littlefishsolutions/Arduino-HRV/Photos - Arduino Installation/SSR Relay board.jpg

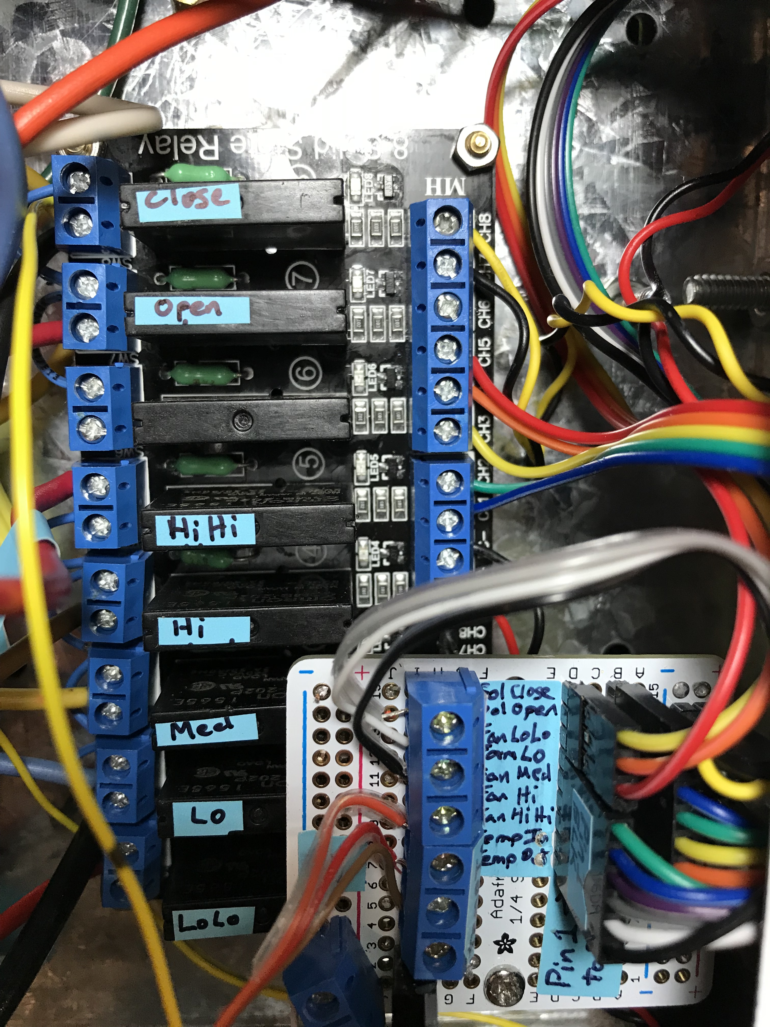
Photos - Arduino Installation/SSR Relay board.jpg
