littlefishsolutions/Arduino-HRV/Photos - Arduino Installation/Remote OLED display enclosure.jpg

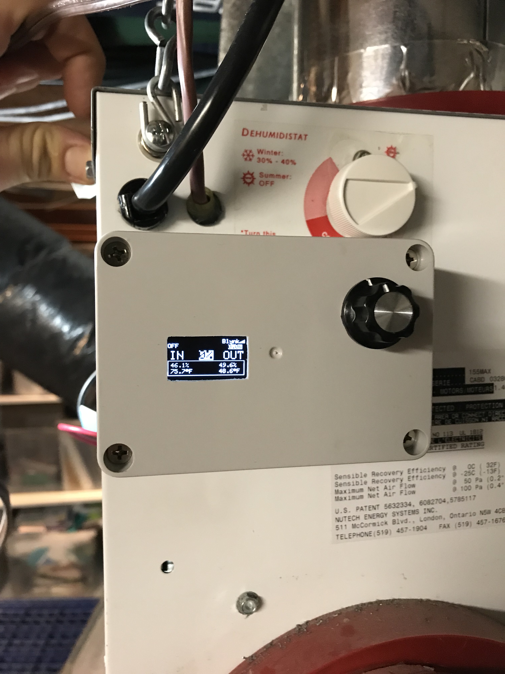
Photos - Arduino Installation/Remote OLED display enclosure.jpg
