littlefishsolutions/Arduino-HRV/README.md

# Arduino-HRV
<h3>HRV Arduino Controller with Air Economizer</H3>

So my history with this project is I live in Minnesota and my HRV PCB board fried.  I always wanted something with an air economizer since our springs and falls are perfect times to take in cool outside air and condition the house rather than turning on the air conditioner or opening windows.  This is where this project fits in.  

I wrote up a detailed description of operation.  Refer to HRV Control Narrative.docx in the source code.  The wiring diagram is also attached in the library.

<H2>HARDWARE:</H2></BR>

(1) [Arduino ESP32](https://www.aliexpress.com/item/Official-DOIT-ESP32-Development-Board-WiFi-Bluetooth-Ultra-Low-Power-Consumption-Dual-Core-ESP-32-ESP/32819024360.html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) - Used due to the amount of GPIO required for this project.  ESP8266 just wasn't enough GPIO.

(1) [120V to 5V step down power supply](https://www.aliexpress.com/item/1x-HLK-PM01-AC-DC-220V-To-5V-Step-Down-Power-Supply-Module-Household-Switch-P0/32795822005.html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) - Don't use the cheap power supply PCB's.  I went through two other types before I found out that this was the most stable.

(2) DHT 22 temperature sensors - [Inside sensor](https://www.aliexpress.com/item/1pcs-Free-Shipping-DHT22-AM2302-Digital-Temperature-and-Humidity-Sensor/1041496689.html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) & [Outside Remote Sensor](https://www.aliexpress.com/item/1PCSX-DHT22-AM2302-Digital-Temperature-and-Humidity-Sensor-AM2302-with-wire/32767774502.html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). Measure inside and outside temperature and humidity.

(1) [0.96" OLED display](https://www.aliexpress.com/item/free-shipping-0-96-inch-OLED-display-module-128X64-OLED-For-arduino-I2C-IIC-SPI-7p/32595065663.html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) for local indication of the mode it is operating and for temp/humidity indication.  Be sure you desolder and solder pins so that board is configured for I2C communication. Instructions for SPI and I2C can be found [here](https://forum.arduino.cc/index.php?topic=472436.0).

(1) [8-Channel SSR 5 Volt High Level trigger relay board](https://www.aliexpress.com/item/Free-Shipping-5V-8-Way-High-Level-Trigger-Solid-State-Relay-Module-with-Fuse-Arduin-250V2A/32572982881.html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)

(1) [LM1117 Linear Voltage regulator](https://www.aliexpress.com/item/10PCS-LM1117T-3-3-TO220-LM1117-3-3-LM1117T-3-3V-LM1117-TO-220-free-shipping/32714386720.html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) to power ESP32 at 3.3V

(1) [Rotary Encoder KY-040](https://www.aliexpress.com/item/The-32TA1600-logic-board-320WA01C-BF-C67271-In-stock-Best-price-and-good-service/599712551.html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) & [Knob](https://www.aliexpress.com/item/5pcs-A01-Bakelite-Knob-20MMxH11-5MM-Mounting-Hole-6MM-For-Rotary-potentiometer-Encoder-Rotary-Switch/32802763478.html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) used as a push button.  Future functionality to include a menu and be able to select modes of operation and control setpoints.

(1) [Enclosure](https://www.aliexpress.com/item/1Pcs-DIY-2-Size-Plastic-Waterproof-Housing-Enclosure-Box-Electronic-Project-Instrument-Case-Outdoor-Junction-Box/32839180611.html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) to house the OLED display and encloder.  Get the large one.  Dimensions are 100mmx68mmx50mm.

<H2>SOFTWARE:</H2></BR>
Blynk App for iOS to control and monitor the status of the controller.  Refer to the Blynk Project Link in the source code.  It is a QR code that you need to scan to clone the configuration to make it yours.

<H2>ARDUINO LIBRARIES USED:</H2></BR>
WiFi.h, WiFiClient.h, BlynkSimpleEsp32.h, ArduinoOTA.h, mDNS.h, WiFiUdp.h, SPI.h, Wire.h, Adafruit_SSD1306.h
