littlefishsolutions/Arduino-HRV/Blynk Project Link - Clone of Project Configuration (Safe to share).jpg

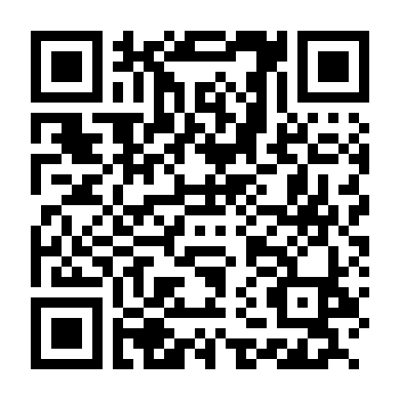
Blynk Project Link - Clone of Project Configuration (Safe to share).jpg
