littlefishsolutions/Arduino-HRV/Wiring Schematic Power and GPIO to ESP32_R1.pdf

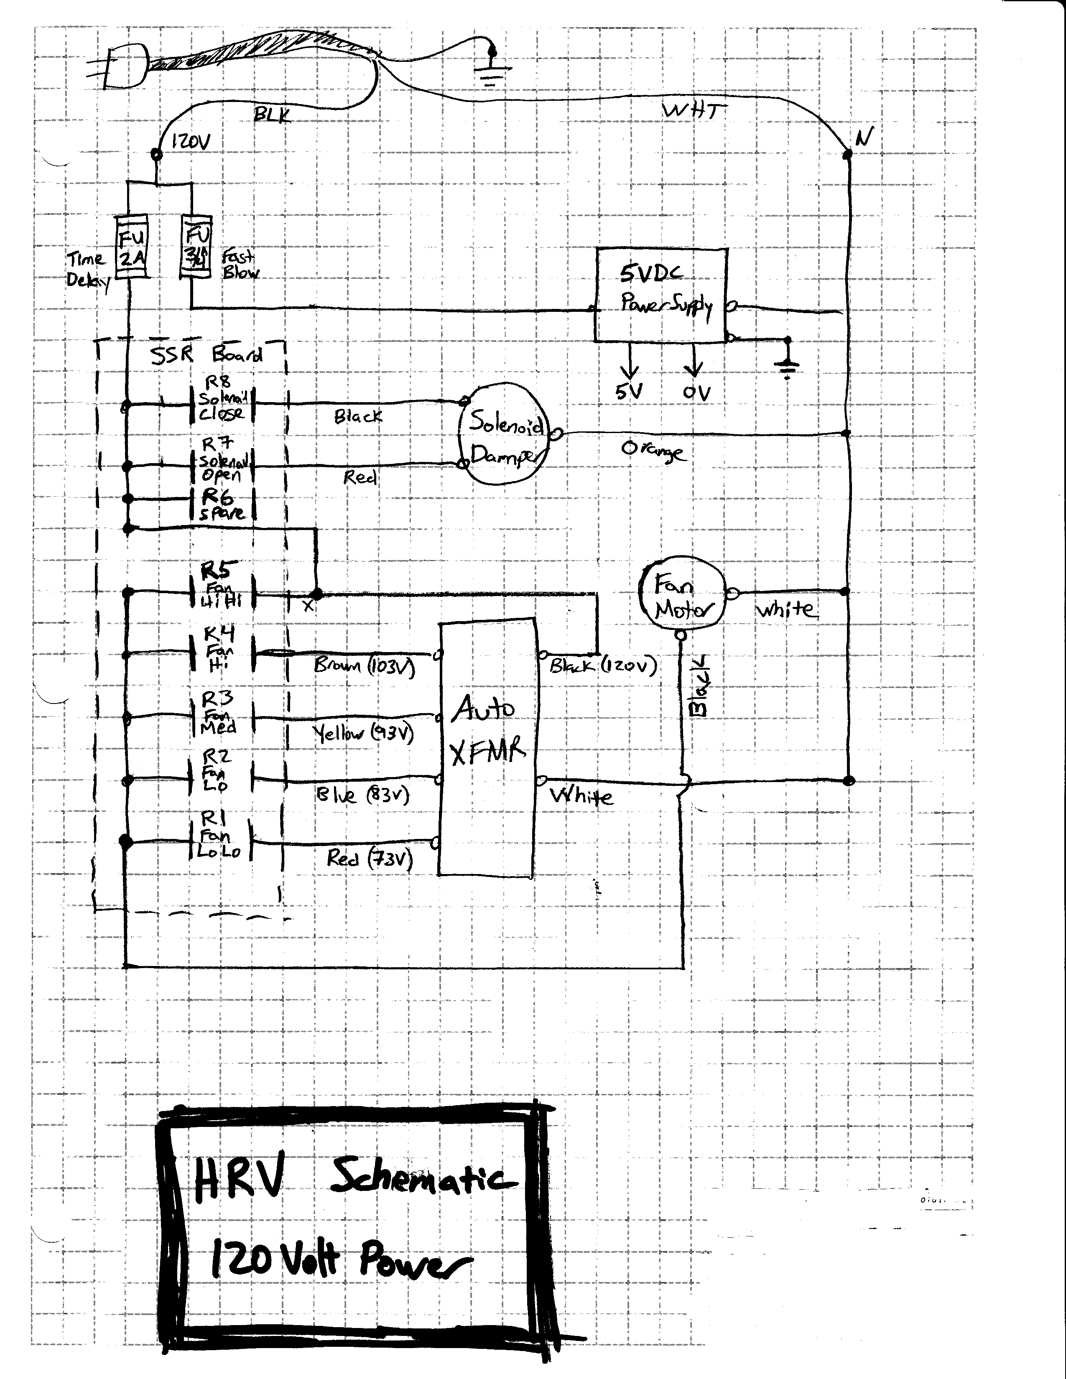
[picture p5: page 1]
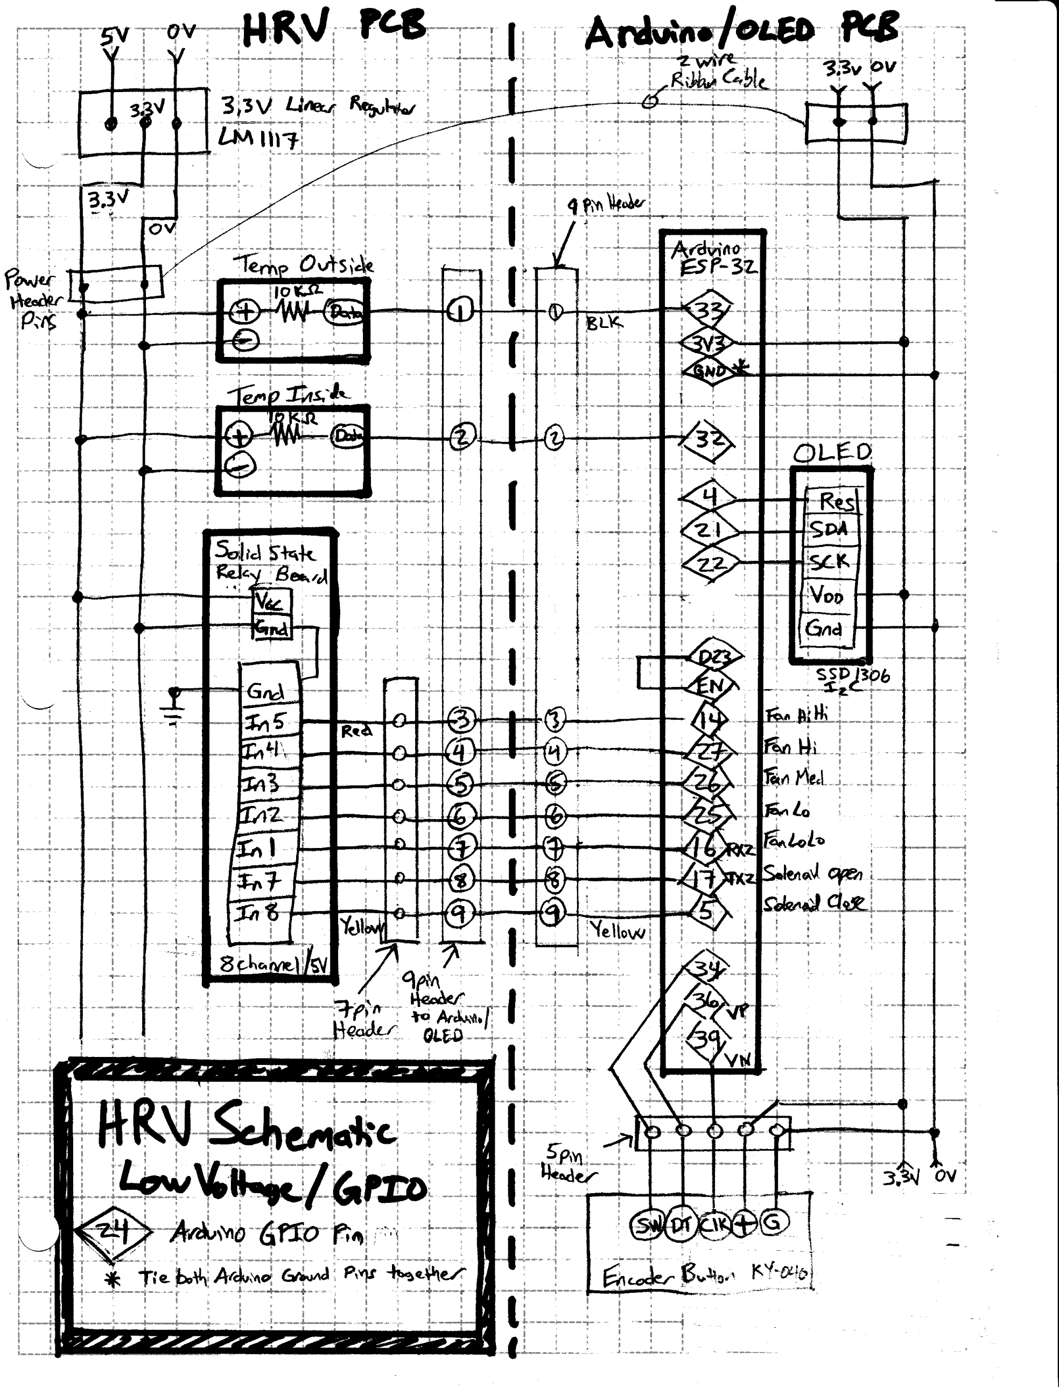
[picture p6: page 2]
