littlefishsolutions/Arduino-HRV/Photos - Arduino Installation/Intake damper and remote DHT22 sensor.jpg

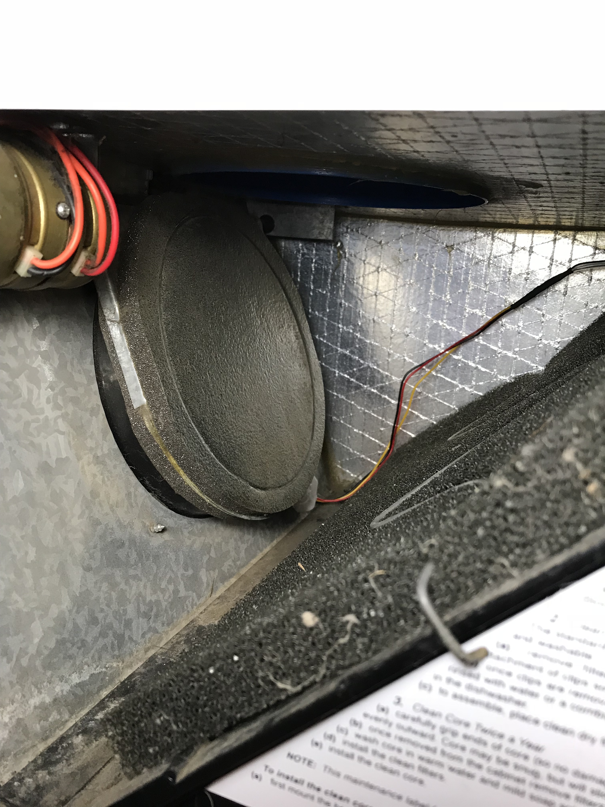
Photos - Arduino Installation/Intake damper and remote DHT22 sensor.jpg
