littlefishsolutions/Arduino-HRV/Photos - Arduino Installation/Internal HRV control enclosure.jpg

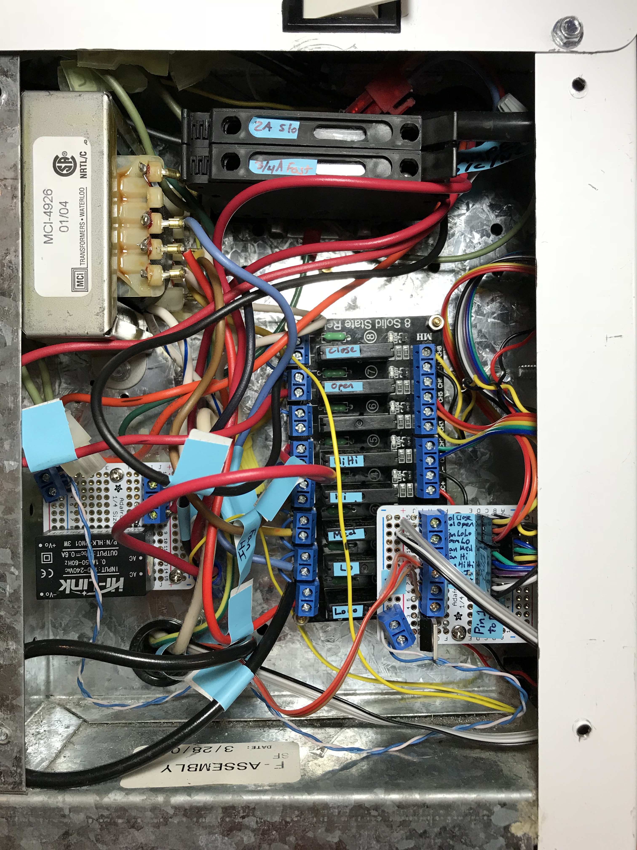
Photos - Arduino Installation/Internal HRV control enclosure.jpg
