littlefishsolutions/Arduino-HRV/Photos - Arduino Installation/Power and OLED breakout board.jpg

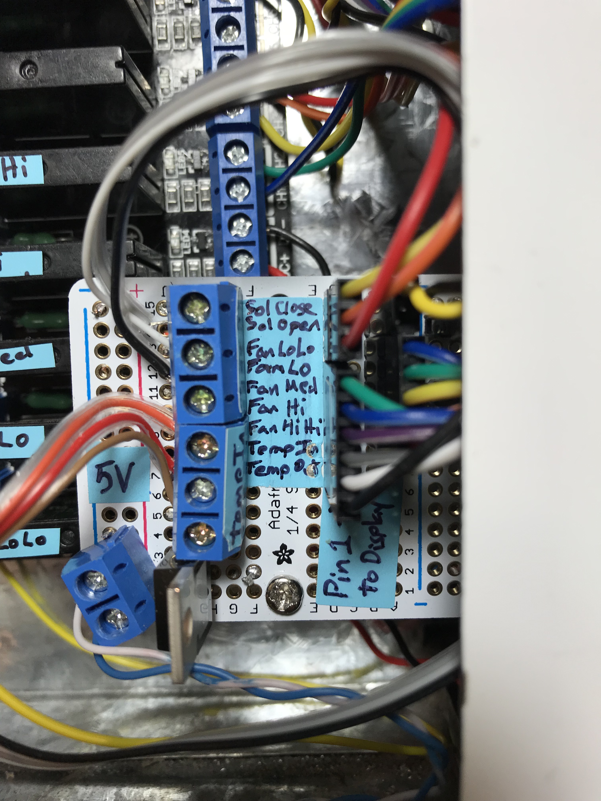
Photos - Arduino Installation/Power and OLED breakout board.jpg
