littlefishsolutions/Arduino-HRV/(commit log)

2018-10-31 Add files via upload
    Initial Commit of Arduino source code
2018-10-31 Add files via upload
    Wiring diagram for all components
2018-10-31 Add files via upload
    Arduino Source Code
